ethandrzb/Eurorack_WS2812_LED_Controller/docs/hardware_requirements.md

# Hardware Requirements

## Front Panel 
### UI
- OLED screen
- Encoder
- 6 push buttons
  - Color palette
  - FX change
  - Global settings
  - Mod matrix
  - TODO: MIDI config
  - TODO: Free button connected to gate input 1

### I/O
- 4 CV inputs with passthrough (buffered?)
- 4 gate inputs
- 3 terminals for LED strip (screw or spring?)
- TRS or 5 pin MIDI jacks?

### Rear Panel
- Keyed Eurorack power header
- MIDI input (and thru?)
- 3 terminals for LED strip (same data signal as front panel)
- Header for CV input expander (4 more CV inputs, same spec)
  - I2C ADC
  - DIP switch for I2C address?
  - Put analog front end for expander inputs on expander to save BOM cost

## PCB
- STM32 F446RE MCU and required circuitry
  - 8 MHz external crystal
- Supporting circuitry for
  - CV inputs (and buffers if applicable)
    - +- 5 or 10 Vpp input range
    - Should handle 10 Vpp with no damage
  - Gate inputs
    - Should handle up to 10 Vpp pulse with no damage
    - Dedicated button for Gate 0
  - MIDI input and thru
- SWD programming header (6-pin, MIPI10, or STDC14)
  - STDC14 is same as MIPI10, but includes pins for a serial port
- USB C connector for DFU + DFU button
- USART6 for debugging?
### PCB Info
- JLC Stackup Code: JLC06161H-7628
- Layer Roles
  1. Signal/Power (+5V)
  2. Ground
  3. Signal/Power (+3V3)
  4. Ground
  5. Ground
  6. Signal/Power
