ethandrzb/Eurorack_WS2812_LED_Controller/docs/CubeMX_ADC1_order_8_CV_inputs.png

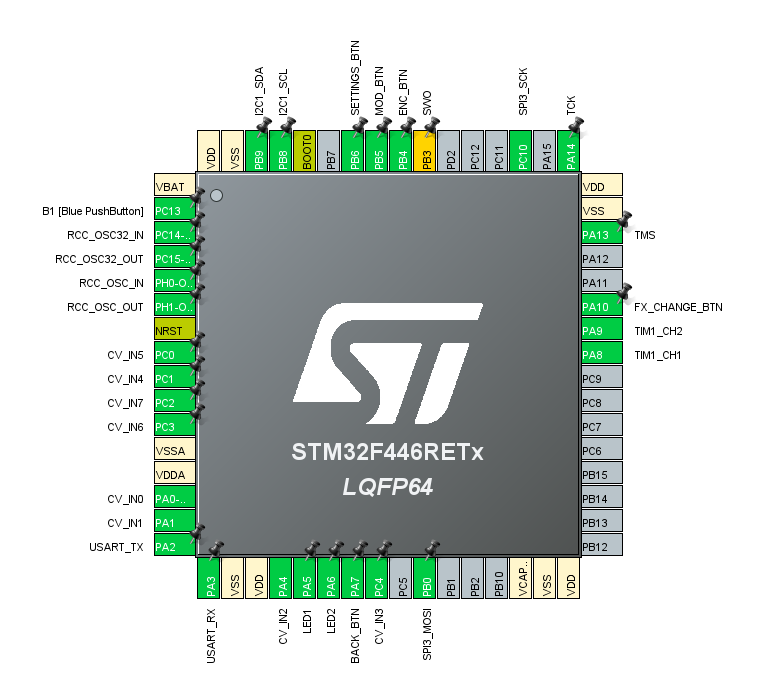
docs/CubeMX_ADC1_order_8_CV_inputs.png
