ethandrzb/Eurorack_WS2812_LED_Controller/eda/Light_Commander/Light_Commander_panel.step

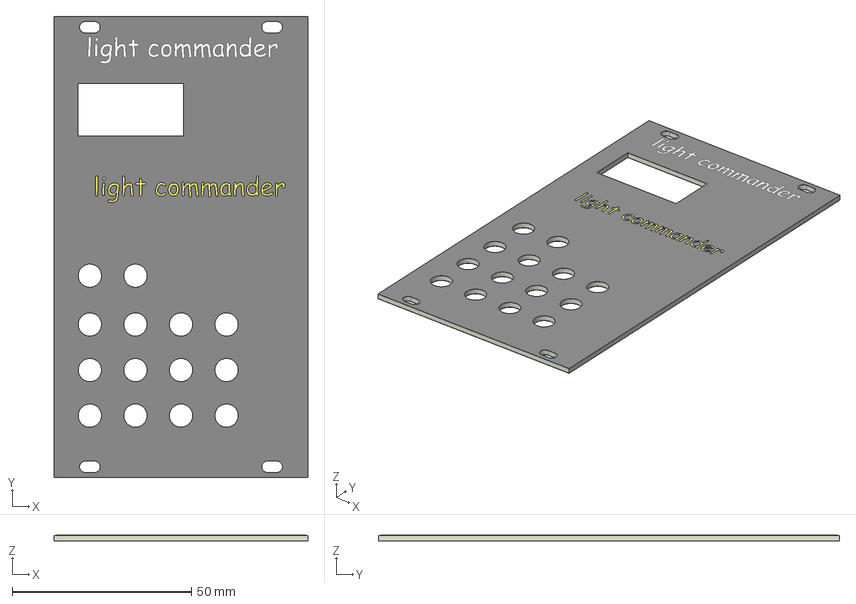
[picture p2: CAD file, 2026-09-30]
eda/Light_Commander/Light_Commander_panel.step
70.8 x 128.5 x 1.64 mm
Light_Commander_panel_copper
Light_Commander_panel_silkscreen
Light_Commander_panel_soldermask x 2
Light_Commander_panel_PCB
