ethandrzb/Eurorack_WS2812_LED_Controller/eda/adc_driver.asc

C1: cap; 49n
C2: cap; 100p
R1: res; 200k
R2: res; 100k
R3: res; 47k
R4: res; 62k
R5: res; 100
R6: res; 10k
R7: res; 100
U1: TL07XH_TL08XH
U2: AD8541
V1: voltage; SINE(0 10 100); AC 1
V2: voltage; 12
V3: voltage; 12
V4: voltage; 2.5
V5: voltage; 3.3
Named nets: 0, vcc, vee, vref
.ac dec 30 1 1e6
.tran 0 130m 100m
