ethandrzb/Eurorack_WS2812_LED_Controller/eda/gate_input.asc

D1: diode; DI_BAT54S
D2: diode; DI_BAT54S
D4: diode; DI_BAT54S
Q1: npn; 2N3904
R1: res; 100k
R2: res; 100k
R3: res; 10k
V1: voltage; SINE(0 10 1k)
V2: voltage; 3.3
V3: voltage; SINE(0 10 1k)
V4: voltage; 3.3
Named nets: 0
.include BAT54S.lib
.tran 3m
