ethandrzb/Eurorack_WS2812_LED_Controller/eda/Light_Commander/Light_Commander.kicad_pcb

## KiCad design eda/Light_Commander/Light_Commander.kicad_pcb (2026-09-30)

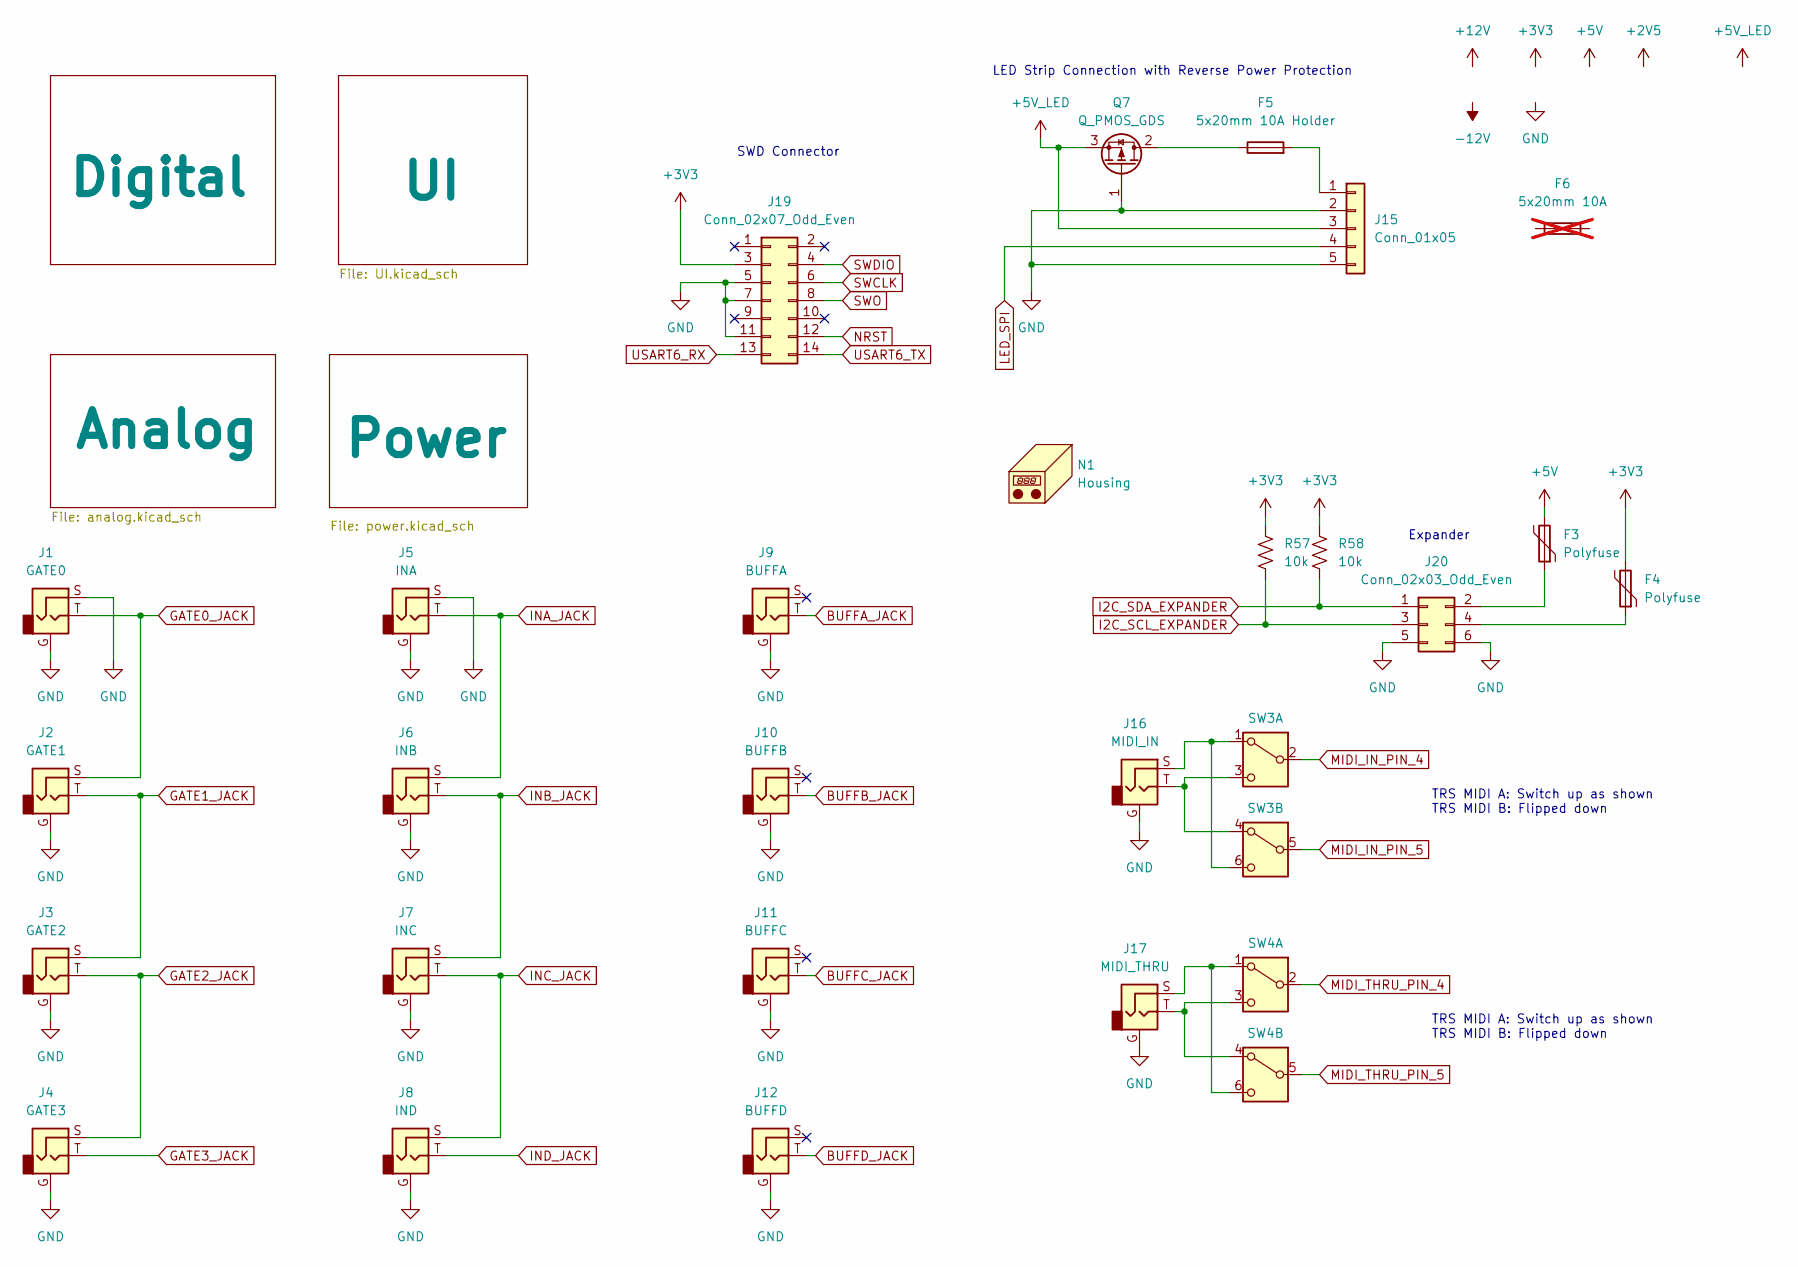
[picture p3: schematic Light_Commander.kicad_sch]

Parts:
F3, F4: Polyfuse; Fuse_0805_2012Metric; Digikey_PN 13-SMDH0805B010TFCT-ND
F5: 5x20mm 10A Holder; 05200101Z; Digikey_PN F1504-ND
F6: 5x20mm 10A; Digikey_PN 0617010.MXP-ND; not fitted
J1: GATE0; PJ301M-12
J2: GATE1; PJ301M-12
J3: GATE2; PJ301M-12
J4: GATE3; PJ301M-12
J5: INA; PJ301M-12
J6: INB; PJ301M-12
J7: INC; PJ301M-12
J8: IND; PJ301M-12
J9: BUFFA; PJ301M-12
J10: BUFFB; PJ301M-12
J11: BUFFC; PJ301M-12
J12: BUFFD; PJ301M-12
J15: Conn_01x05; CUI_TBLH10V-350-05BK; Digikey_PN 102-TBLH10V-350-05BK-ND
J16: MIDI_IN; PJ301M-12_STEREO
J17: MIDI_THRU; PJ301M-12_STEREO
J19: Conn_02x07_Odd_Even; SAMTEC_FTSH-107-01-L-DV-K-A; Digikey_PN FTSH-107-01-L-DV-K-A-ND
J20: Conn_02x03_Odd_Even; IDC-Header_2x03_P2.54mm_Vertical; Digikey_PN S9716-ND
N1: Housing; Light_Commander_Panel
Q7: Q_PMOS_GDS; TO-252-2; Digikey_PN 4786-SSFD6909CT-ND
R57, R58: 10k; R_0805_2012Metric; Digikey_PN 311-10.0KCRCT-ND
SW3, SW4: SW_DPDT_x2; CAS-220TA; Digikey_PN CAS220JCT-ND

Connections:
+3V3: F4.2, J19.3, R57.1, R58.1; also elsewhere on the board
+5V: F3.2; also elsewhere on the board
+5V_LED: J15.3, Q7.3 (S); also elsewhere on the board
BUFFA_JACK: J9.T; also elsewhere on the board
BUFFB_JACK: J10.T; also elsewhere on the board
BUFFC_JACK: J11.T; also elsewhere on the board
BUFFD_JACK: J12.T; also elsewhere on the board
GATE0_JACK: J1.T, J2.S; also elsewhere on the board
GATE1_JACK: J2.T, J3.S; also elsewhere on the board
GATE2_JACK: J3.T, J4.S; also elsewhere on the board
GATE3_JACK: J4.T; also elsewhere on the board
GND: J1.G, J1.S, J2.G, J3.G, J4.G, J5.G, J5.S, J6.G, J7.G, J8.G, J9.G, J10.G, J11.G, J12.G, J15.2, J15.5, J16.G, J17.G, J19.5, J19.7, J19.11, J20.5, J20.6, Q7.1 (G); also elsewhere on the board
I2C_SCL_EXPANDER: J20.3, R57.2; also elsewhere on the board
I2C_SDA_EXPANDER: J20.1, R58.2; also elsewhere on the board
INA_JACK: J5.T, J6.S; also elsewhere on the board
INB_JACK: J6.T, J7.S; also elsewhere on the board
INC_JACK: J7.T, J8.S; also elsewhere on the board
IND_JACK: J8.T; also elsewhere on the board
LED_SPI: J15.4; also elsewhere on the board
MIDI_IN_PIN_4: SW3.2 (B); also elsewhere on the board
MIDI_IN_PIN_5: SW3.5 (B); also elsewhere on the board
MIDI_THRU_PIN_4: SW4.2 (B); also elsewhere on the board
MIDI_THRU_PIN_5: SW4.5 (B); also elsewhere on the board
NRST: J19.12; also elsewhere on the board
unnamed: F5.2, J15.1
unnamed: F3.1, J20.2
unnamed: F4.1, J20.4
unnamed: F5.1, Q7.2 (D)
unnamed: J16.S, SW3.1 (A), SW3.6 (C)
unnamed: J16.T, SW3.3 (C), SW3.4 (A)
unnamed: J17.S, SW4.1 (A), SW4.6 (C)
unnamed: J17.T, SW4.3 (C), SW4.4 (A)
SWCLK: J19.6; also elsewhere on the board
SWDIO: J19.4; also elsewhere on the board
SWO: J19.8; also elsewhere on the board
USART6_RX: J19.13; also elsewhere on the board
USART6_TX: J19.14; also elsewhere on the board

Notes on the sheet:
TRS MIDI A: Switch up as shown TRS MIDI B: Flipped down
Expander
SWD Connector
LED Strip Connection with Reverse Power Protection

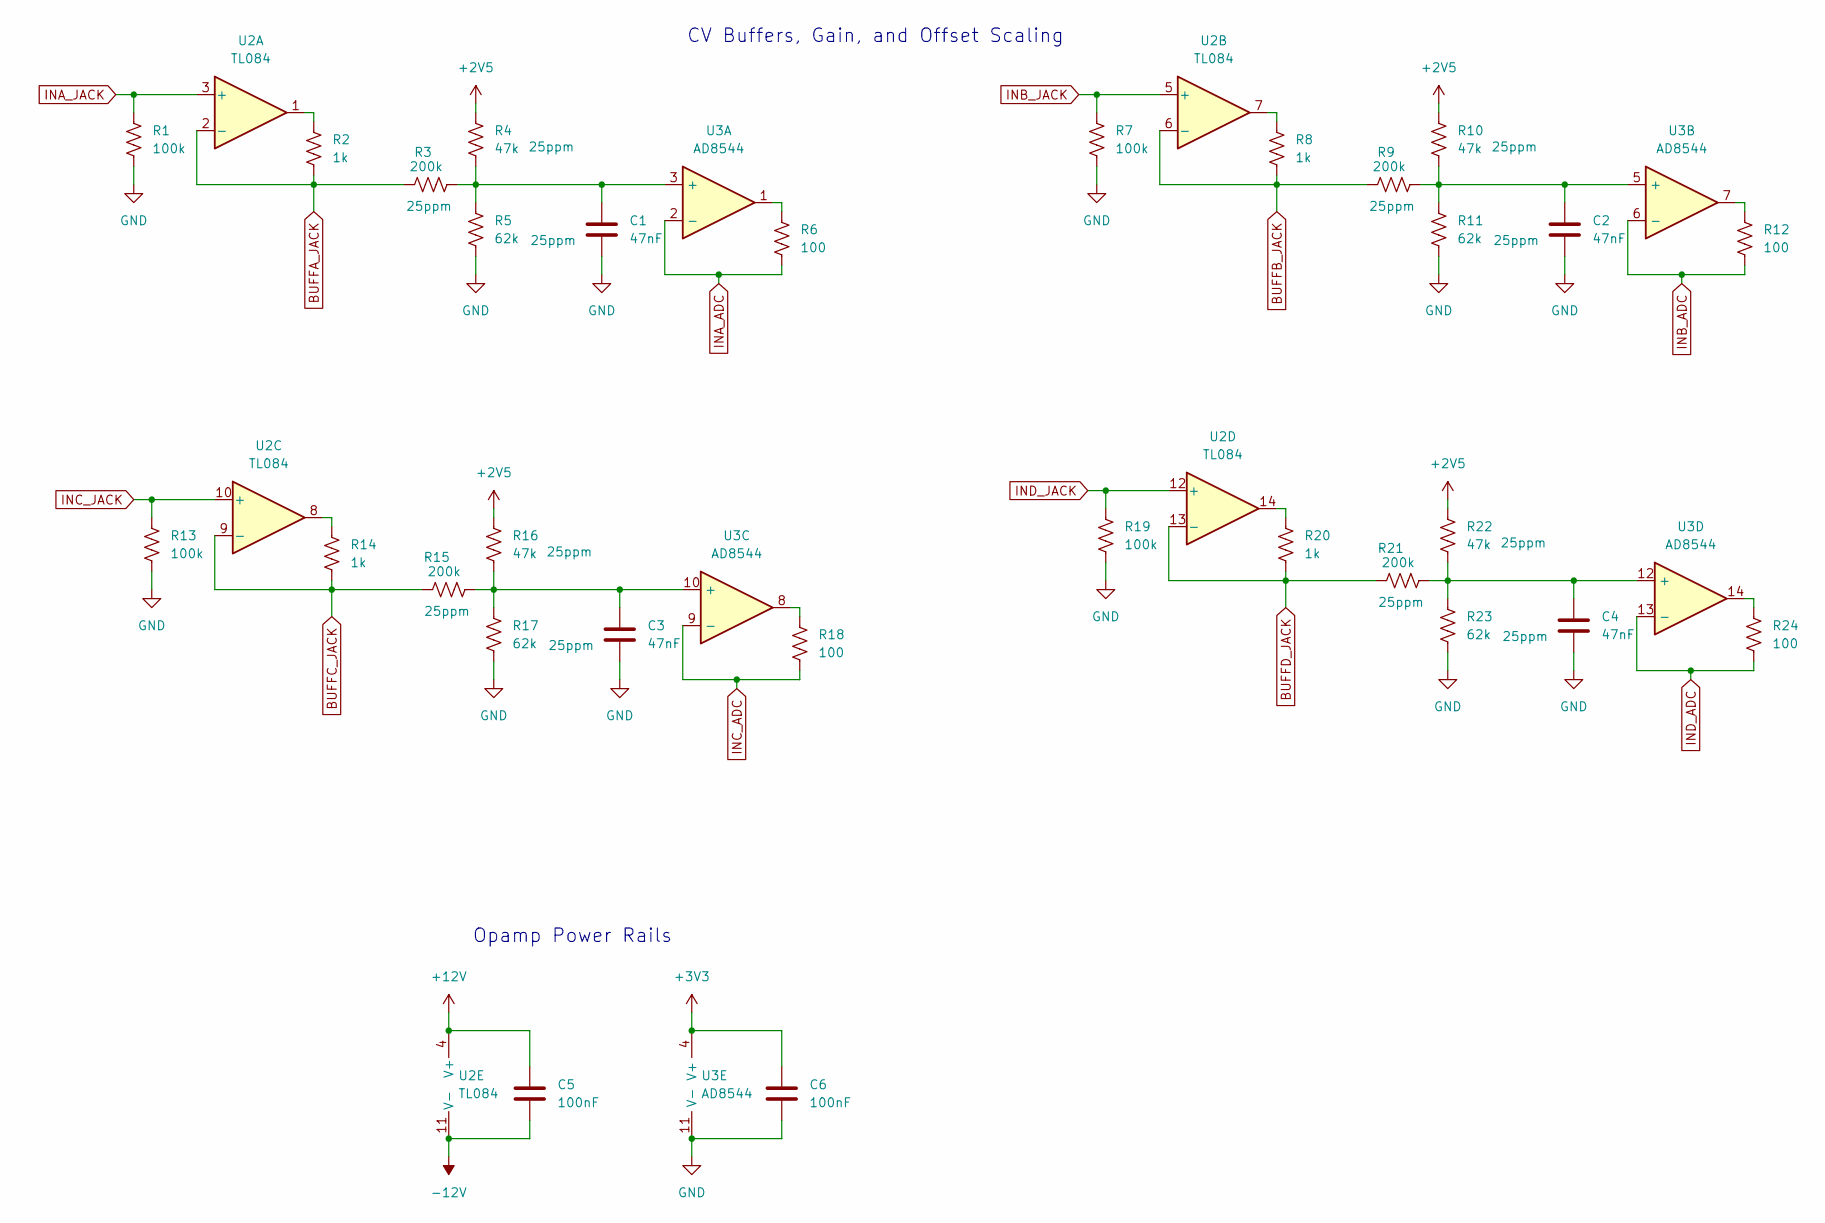
[picture p4: schematic analog.kicad_sch]

Parts:
C1, C2, C3, C4: 47nF; C_0805_2012Metric; Digikey_PN 399-C0805C473J3GECTUCT-ND
C5, C6: 100nF; C_0805_2012Metric; Digikey_PN 1276-1003-1-ND
R1, R7, R13, R19: 100k; R_0805_2012Metric; Digikey_PN 311-100KCRCT-ND
R2, R8, R14, R20: 1k; R_0805_2012Metric; Digikey_PN 541-1.00KCCT-ND
R3, R9, R15, R21: 200k; R_0805_2012Metric; Digikey_PN RG20P200KBCT-ND
R4, R10, R16, R22: 47k; R_0805_2012Metric; Digikey_PN RG20P47.0KBCT-ND
R5, R11, R17, R23: 62k; R_0805_2012Metric; Digikey_PN P62KDACT-ND
R6, R12, R18, R24: 100; R_0805_2012Metric; Digikey_PN 311-100CRCT-ND
U2: TL084; SOIC-14_3.9x8.7mm_P1.27mm; Digikey_PN 296-TL084HIDRCT-ND
U3: AD8544; SOIC-14_3.9x8.7mm_P1.27mm; Digikey_PN AD8544ARZ-REELCT-ND

Connections:
+2V5: R4.1, R10.1, R16.1, R22.1; also elsewhere on the board
+3V3: C6.1, U3.4 (V+); also elsewhere on the board
+12V: C5.1, U2.4 (V+); also elsewhere on the board
-12V: C5.2, U2.11 (V-); also elsewhere on the board
BUFFA_JACK: R2.2, R3.1, U2.2 (-); also elsewhere on the board
BUFFB_JACK: R8.2, R9.1, U2.6 (-); also elsewhere on the board
BUFFC_JACK: R14.2, R15.1, U2.9 (-); also elsewhere on the board
BUFFD_JACK: R20.2, R21.1, U2.13 (-); also elsewhere on the board
GND: C1.2, C2.2, C3.2, C4.2, C6.2, R1.2, R5.2, R7.2, R11.2, R13.2, R17.2, R19.2, R23.2, U3.11 (V-); also elsewhere on the board
INA_ADC: R6.1, U3.2 (-); also elsewhere on the board
INA_JACK: R1.1, U2.3 (+); also elsewhere on the board
INB_ADC: R12.1, U3.6 (-); also elsewhere on the board
INB_JACK: R7.1, U2.5 (+); also elsewhere on the board
INC_ADC: R18.1, U3.9 (-); also elsewhere on the board
INC_JACK: R13.1, U2.10 (+); also elsewhere on the board
IND_ADC: R24.1, U3.13 (-); also elsewhere on the board
IND_JACK: R19.1, U2.12 (+); also elsewhere on the board
unnamed: R2.1, U2.1
unnamed: R6.2, U3.1
unnamed: R8.1, U2.7
unnamed: R12.2, U3.7
unnamed: R14.1, U2.8
unnamed: R18.2, U3.8
unnamed: R20.1, U2.14
unnamed: R24.2, U3.14
unnamed: C1.1, R3.2, R4.2, R5.1, U3.3 (+)
unnamed: C2.1, R9.2, R10.2, R11.1, U3.5 (+)
unnamed: C3.1, R15.2, R16.2, R17.1, U3.10 (+)
unnamed: C4.1, R21.2, R22.2, R23.1, U3.12 (+)

Notes on the sheet:
CV Buffers, Gain, and Offset Scaling
Opamp Power Rails

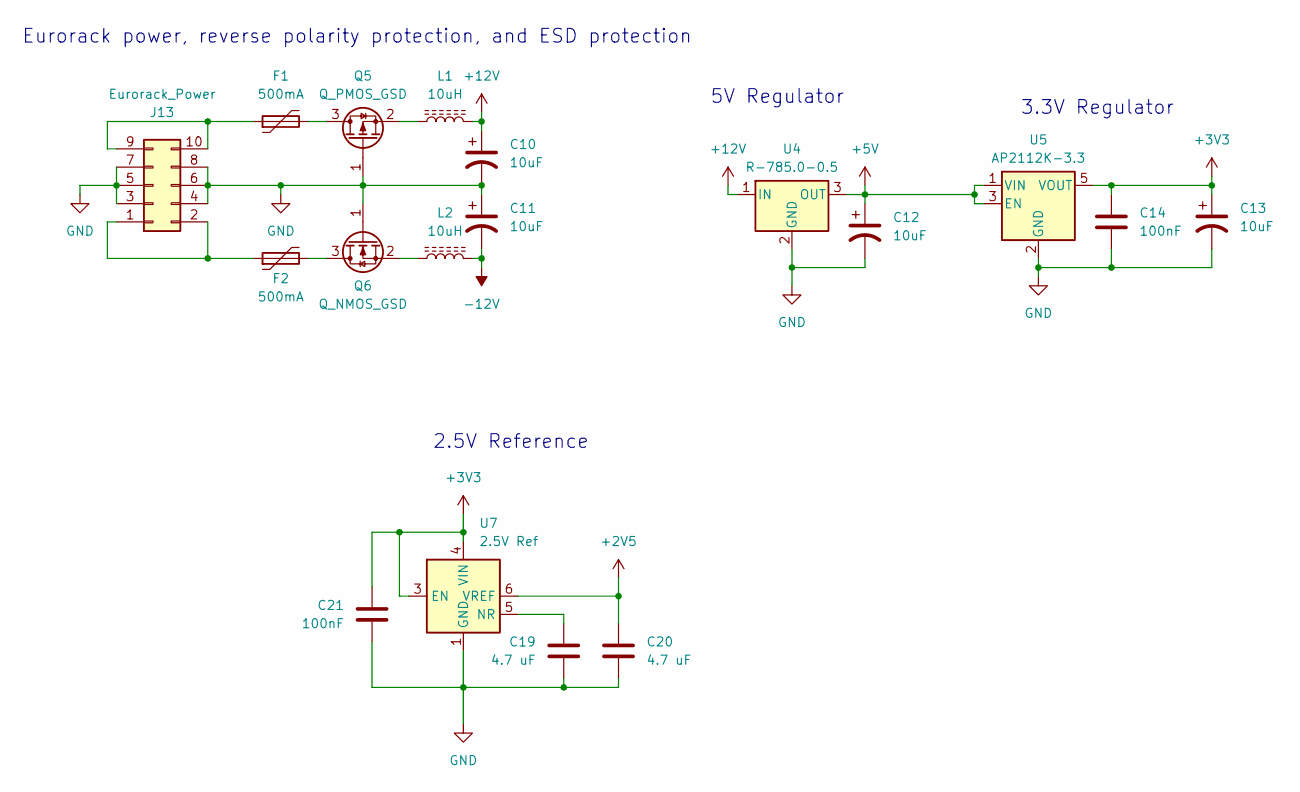
[picture p5: schematic power.kicad_sch]

Parts:
C10, C11, C12, C13: 10uF; C_Elec_6.3x7.7; Digikey_PN 732-11937-1-ND
C14, C21: 100nF; C_0805_2012Metric; Digikey_PN 1276-1003-1-ND
C19, C20: 4.7 uF; C_0805_2012Metric; Digikey_PN 1276-1244-1-ND
F1, F2: 500mA; Fuse_1206_3216Metric; Digikey_PN F2110CT-ND
J13: Eurorack_Power; IDC-Header_2x05_P2.54mm_Vertical; Digikey_PN S9169-ND
L1, L2: 10uH; L_1210_3225Metric; Digikey_PN 445-TFM322512ALVA100MTAACT-ND
Q5: Q_PMOS_GSD; SOT-23-3; Digikey_PN 4518-SI2303CT-ND
Q6: Q_NMOS_GSD; SOT-23-3; Digikey_PN 4518-SI2318ACT-ND
U4: R-785.0-0.5; Converter_DCDC_RECOM_R-78E-0.5_THT; Digikey_PN 945-R-78K5.0-0.5-ND
U5: AP2112K-3.3; SOT-23-5; Digikey_PN AP2112K-3.3TRG1DICT-ND
U7: 2.5V Ref; SOT-23-6; Digikey_PN 296-REF35250QDBVRCT-ND

Connections:
+2V5: C20.2, U7.6 (VREF); also elsewhere on the board
+3V3: C13.1, C14.2, C21.2, U5.5 (VOUT), U7.3 (EN), U7.4 (VIN); also elsewhere on the board
+5V: C12.1, U4.3 (OUT), U5.1 (VIN), U5.3 (EN); also elsewhere on the board
+12V: C10.1, L1.2, U4.1 (IN); also elsewhere on the board
-12V: C11.2, L2.2; also elsewhere on the board
GND: C10.2, C11.1, C12.2, C13.2, C14.1, C19.1, C20.1, C21.1, J13.3, J13.4, J13.5, J13.6, J13.7, J13.8, Q5.1 (G), Q6.1 (G), U4.2 (GND), U5.2 (GND), U7.1 (GND), U7.2 (GND); also elsewhere on the board
unnamed: F2.1, J13.1, J13.2
unnamed: F1.1, J13.9, J13.10
unnamed: F1.2, Q5.3 (D)
unnamed: L1.1, Q5.2 (S)
unnamed: F2.2, Q6.3 (D)
unnamed: L2.1, Q6.2 (S)
unnamed: C19.2, U7.5 (NR)

Notes on the sheet:
5V Regulator
2.5V Reference
Eurorack power, reverse polarity protection, and ESD protection
3.3V Regulator

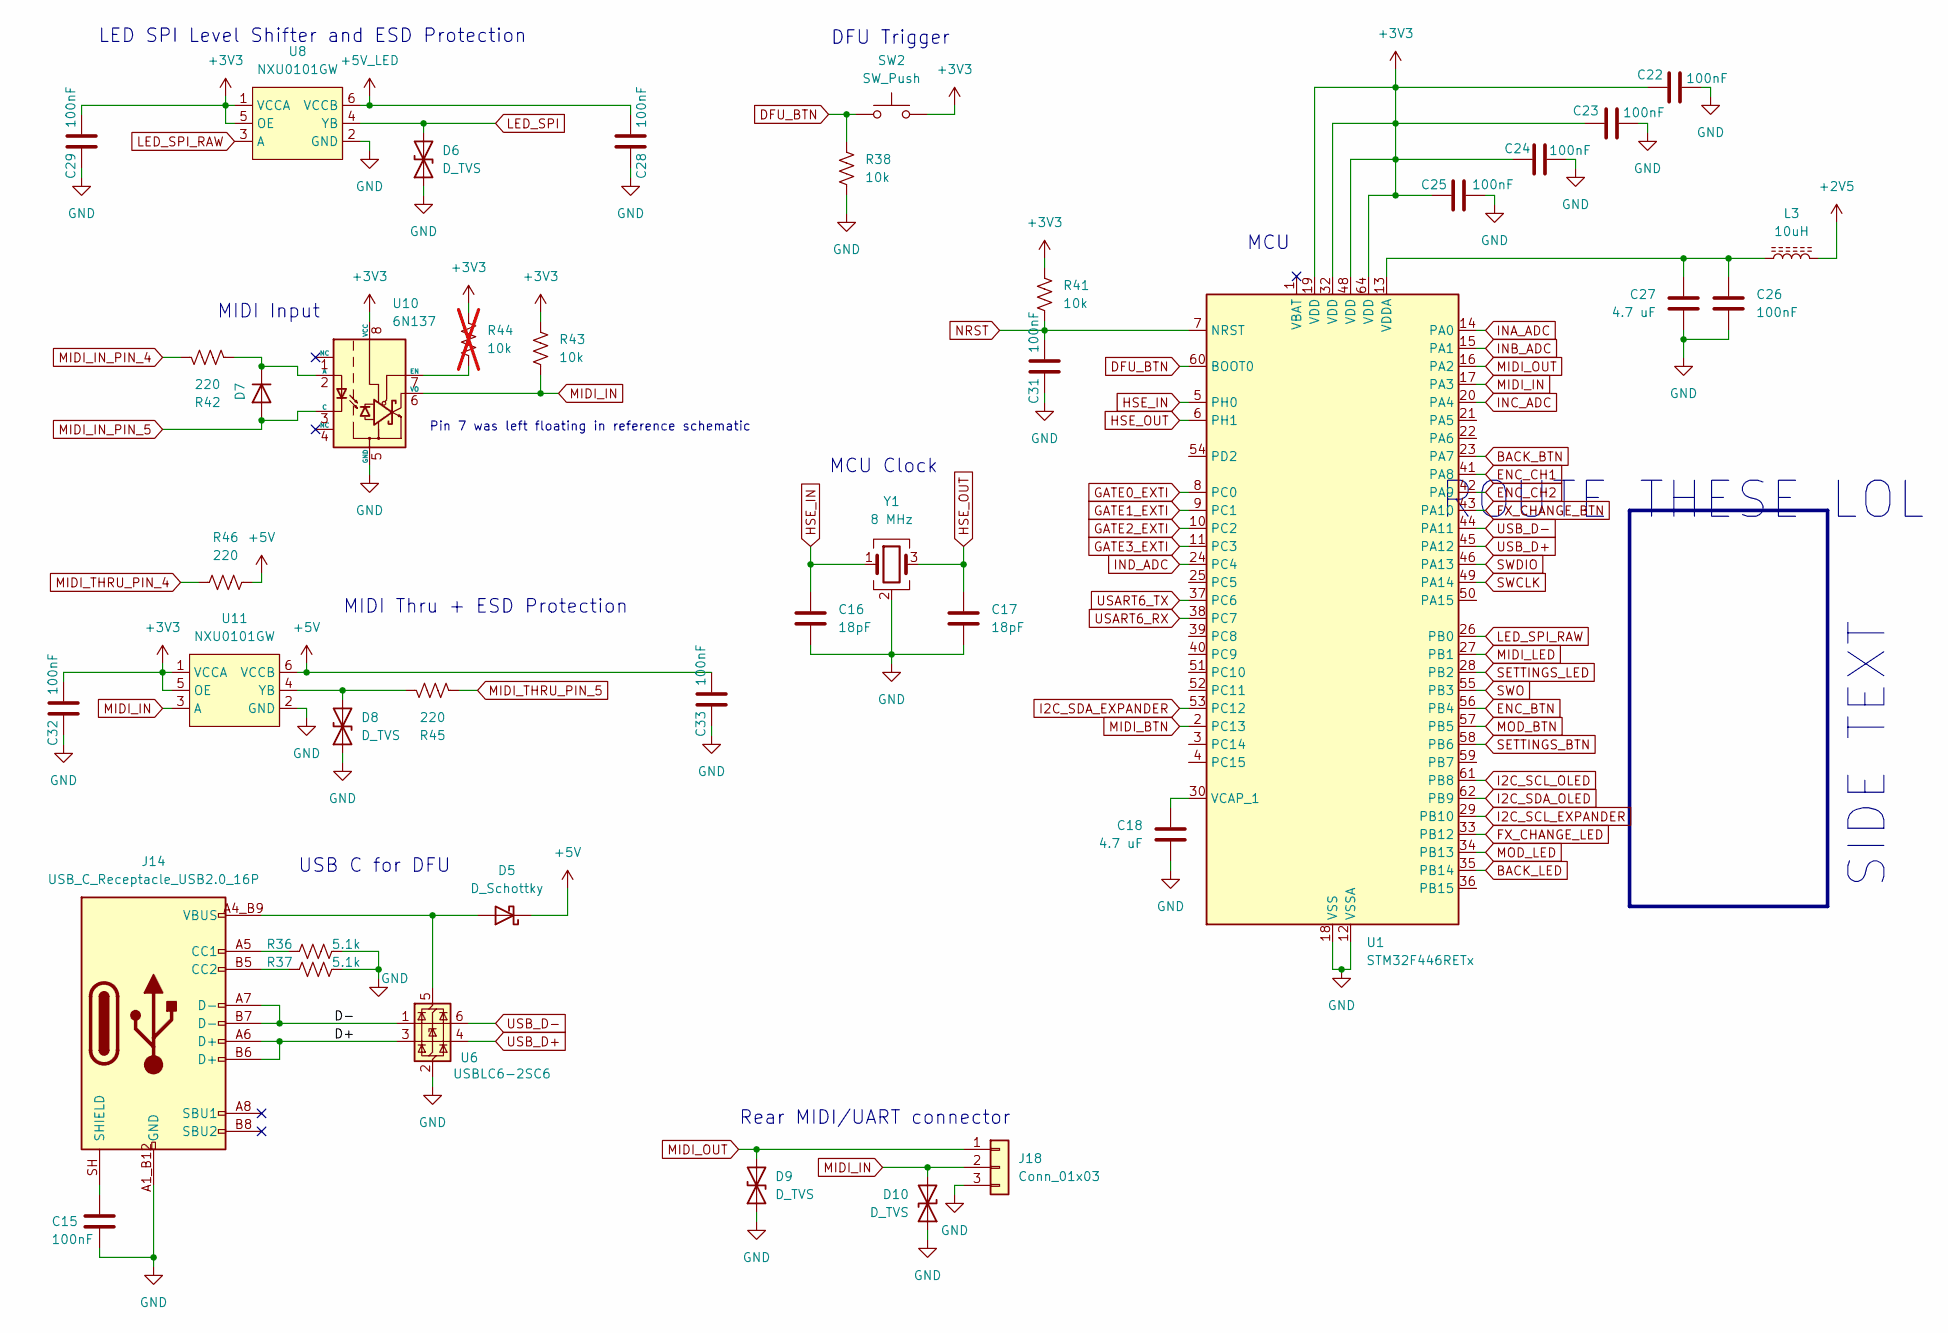
[picture p6: schematic digital.kicad_sch]

Parts:
C15, C22, C23, C24, C25, C26, C28, C29, C31, C32, C33: 100nF; C_0805_2012Metric; Digikey_PN 1276-1003-1-ND
C16, C17: 18pF; C_0402_1005Metric; Digikey_PN 490-5858-1-ND
C18, C27: 4.7 uF; C_0805_2012Metric; Digikey_PN 1276-1244-1-ND
D5: D_Schottky; D_SOD-123; Digikey_PN 5399-1N5817WCT-ND
D6, D8, D9, D10: D_TVS; D_SOD-123F; Digikey_PN 4786-GSMF5.0CACT-ND
D7: D; D_SOD-123; Digikey_PN 1N4148WTPMSCT-ND
J14: USB_C_Receptacle_USB2.0_16P; UJ20-C-H-G-SMT-1-P16-TR; Digikey_PN 2223-UJ20-C-H-G-SMT-1-P16-TRCT-ND
J18: Conn_01x03; PinHeader_1x03_P2.54mm_Vertical
L3: 10uH; L_1210_3225Metric; Digikey_PN 445-TFM322512ALVA100MTAACT-ND
R36, R37: 5.1k; R_0805_2012Metric; Digikey_PN 311-5.10KCRCT-ND
R38, R41, R43: 10k; R_0805_2012Metric; Digikey_PN 311-10.0KCRCT-ND
R42, R45, R46: 220; R_0805_2012Metric; Digikey_PN 311-220ARCT-ND
R44: 10k; R_0805_2012Metric; Digikey_PN 311-10.0KCRCT-ND; not fitted
SW2: SW_Push; TS09-63-25-R-160-SMT-TR; Digikey_PN 2223-TS09-63-25-R-260-SMT-TRCT-ND
U1: STM32F446RETx; LQFP-64_10x10mm_P0.5mm; Digikey_PN 497-15376-ND
U6: USBLC6-2SC6; SOT-23-6; Digikey_PN 497-5235-1-ND
U8: NXU0101GW; SOT-363_SC-70-6
U10: 6N137; SOP-8_6.605x9.655mm_P2.54mm; Digikey_PN 58-6N137SMT&RCT-ND
U11: NXU0101GW; SOT-363_SC-70-6; Digikey_PN 1727-NXU0101GWHCT-ND
Y1: 8 MHz; ECS-80-18-33-JGN-TR; Digikey_PN 50-ECS-80-18-33-JGN-CT-ND

Connections:
+2V5: L3.2; also elsewhere on the board
+3V3: C22.2, C23.1, C24.1, C25.2, C29.1, C32.1, R41.1, R43.1, R44.1, SW2.2, U1.19 (VDD), U1.32 (VDD), U1.48 (VDD), U1.64 (VDD), U8.1 (VCCA), U8.5 (OE), U10.8 (VCC), U11.1 (VCCA), U11.5 (OE); also elsewhere on the board
+5V: C33.1, D5.1 (K), R46.1, U11.6 (VCCB); also elsewhere on the board
+5V_LED: C28.1, U8.6 (VCCB); also elsewhere on the board
/Digital/D+: J14.A6 (D+), J14.B6 (D+), U6.3 (I/O2)
/Digital/D-: J14.A7 (D-), J14.B7 (D-), U6.1 (I/O1)
BACK_BTN: U1.23 (PA7); also elsewhere on the board
BACK_LED: U1.35 (PB14); also elsewhere on the board
DFU_BTN: R38.1, SW2.1, U1.60 (BOOT0)
ENC_BTN: U1.56 (PB4); also elsewhere on the board
ENC_CH1: U1.41 (PA8); also elsewhere on the board
ENC_CH2: U1.42 (PA9); also elsewhere on the board
FX_CHANGE_BTN: U1.43 (PA10); also elsewhere on the board
FX_CHANGE_LED: U1.33 (PB12); also elsewhere on the board
GATE0_EXTI: U1.8 (PC0); also elsewhere on the board
GATE1_EXTI: U1.9 (PC1); also elsewhere on the board
GATE2_EXTI: U1.10 (PC2); also elsewhere on the board
GATE3_EXTI: U1.11 (PC3); also elsewhere on the board
GND: C15.2, C16.2, C17.2, C18.1, C22.1, C23.2, C24.2, C25.1, C26.1, C27.1, C28.2, C29.2, C31.2, C32.2, C33.2, D6.1 (A1), D8.1 (A1), D9.1 (A1), D10.1 (A1), J14.A1_B12 (GND), J14.B1_A12 (GND), J18.3, R36.1, R37.1, R38.2, U1.12 (VSSA), U1.18 (VSS), U1.31 (VSS), U1.47 (VSS), U1.63 (VSS), U6.2 (GND), U8.2 (GND), U10.5 (GND), U11.2 (GND), Y1.2 (G), Y1.4 (G); also elsewhere on the board
HSE_IN: C16.1, U1.5 (PH0), Y1.1
HSE_OUT: C17.1, U1.6 (PH1), Y1.3
I2C_SCL_EXPANDER: U1.29 (PB10); also elsewhere on the board
I2C_SCL_OLED: U1.61 (PB8); also elsewhere on the board
I2C_SDA_EXPANDER: U1.53 (PC12); also elsewhere on the board
I2C_SDA_OLED: U1.62 (PB9); also elsewhere on the board
INA_ADC: U1.14 (PA0); also elsewhere on the board
INB_ADC: U1.15 (PA1); also elsewhere on the board
INC_ADC: U1.20 (PA4); also elsewhere on the board
IND_ADC: U1.24 (PC4); also elsewhere on the board
LED_SPI: D6.2 (A2), U8.4 (YB); also elsewhere on the board
LED_SPI_RAW: U1.26 (PB0), U8.3 (A)
MIDI_BTN: U1.2 (PC13); also elsewhere on the board
MIDI_IN: D10.2 (A2), J18.2, R43.2, U1.17 (PA3), U10.6 (VO), U11.3 (A)
MIDI_IN_PIN_4: R42.2; also elsewhere on the board
MIDI_IN_PIN_5: D7.2 (A), U10.3 (C); also elsewhere on the board
MIDI_LED: U1.27 (PB1); also elsewhere on the board
MIDI_OUT: D9.2 (A2), J18.1, U1.16 (PA2)
MIDI_THRU_PIN_4: R46.2; also elsewhere on the board
MIDI_THRU_PIN_5: R45.1; also elsewhere on the board
MOD_BTN: U1.57 (PB5); also elsewhere on the board
MOD_LED: U1.34 (PB13); also elsewhere on the board
NRST: C31.1, R41.2, U1.7 (NRST); also elsewhere on the board
unnamed: D5.2 (A), J14.A4_B9 (VBUS), J14.B4_A9 (VBUS), U6.5 (VBUS)
unnamed: D7.1 (K), R42.1, U10.2 (A)
unnamed: D8.2 (A2), R45.2, U11.4 (YB)
unnamed: J14.A5 (CC1), R36.2
unnamed: J14.B5 (CC2), R37.2
unnamed: C15.1, J14.SH (SHIELD)
unnamed: C18.2, U1.30 (VCAP_1)
unnamed: C26.2, C27.2, L3.1, U1.13 (VDDA)
unnamed: R44.2, U10.7 (EN)
SETTINGS_BTN: U1.58 (PB6); also elsewhere on the board
SETTINGS_LED: U1.28 (PB2); also elsewhere on the board
SWCLK: U1.49 (PA14); also elsewhere on the board
SWDIO: U1.46 (PA13); also elsewhere on the board
SWO: U1.55 (PB3); also elsewhere on the board
USART6_RX: U1.38 (PC7); also elsewhere on the board
USART6_TX: U1.37 (PC6); also elsewhere on the board
USB_D+: U1.45 (PA12), U6.4 (I/O2)
USB_D-: U1.44 (PA11), U6.6 (I/O1)

Notes on the sheet:
Rear MIDI/UART connector
MCU
MIDI Input
USB C for DFU
SIDE TEXT
MCU Clock
MIDI Thru + ESD Protection
DFU Trigger
Pin 7 was left floating in reference schematic
ROUTE THESE LOL
LED SPI Level Shifter and ESD Protection

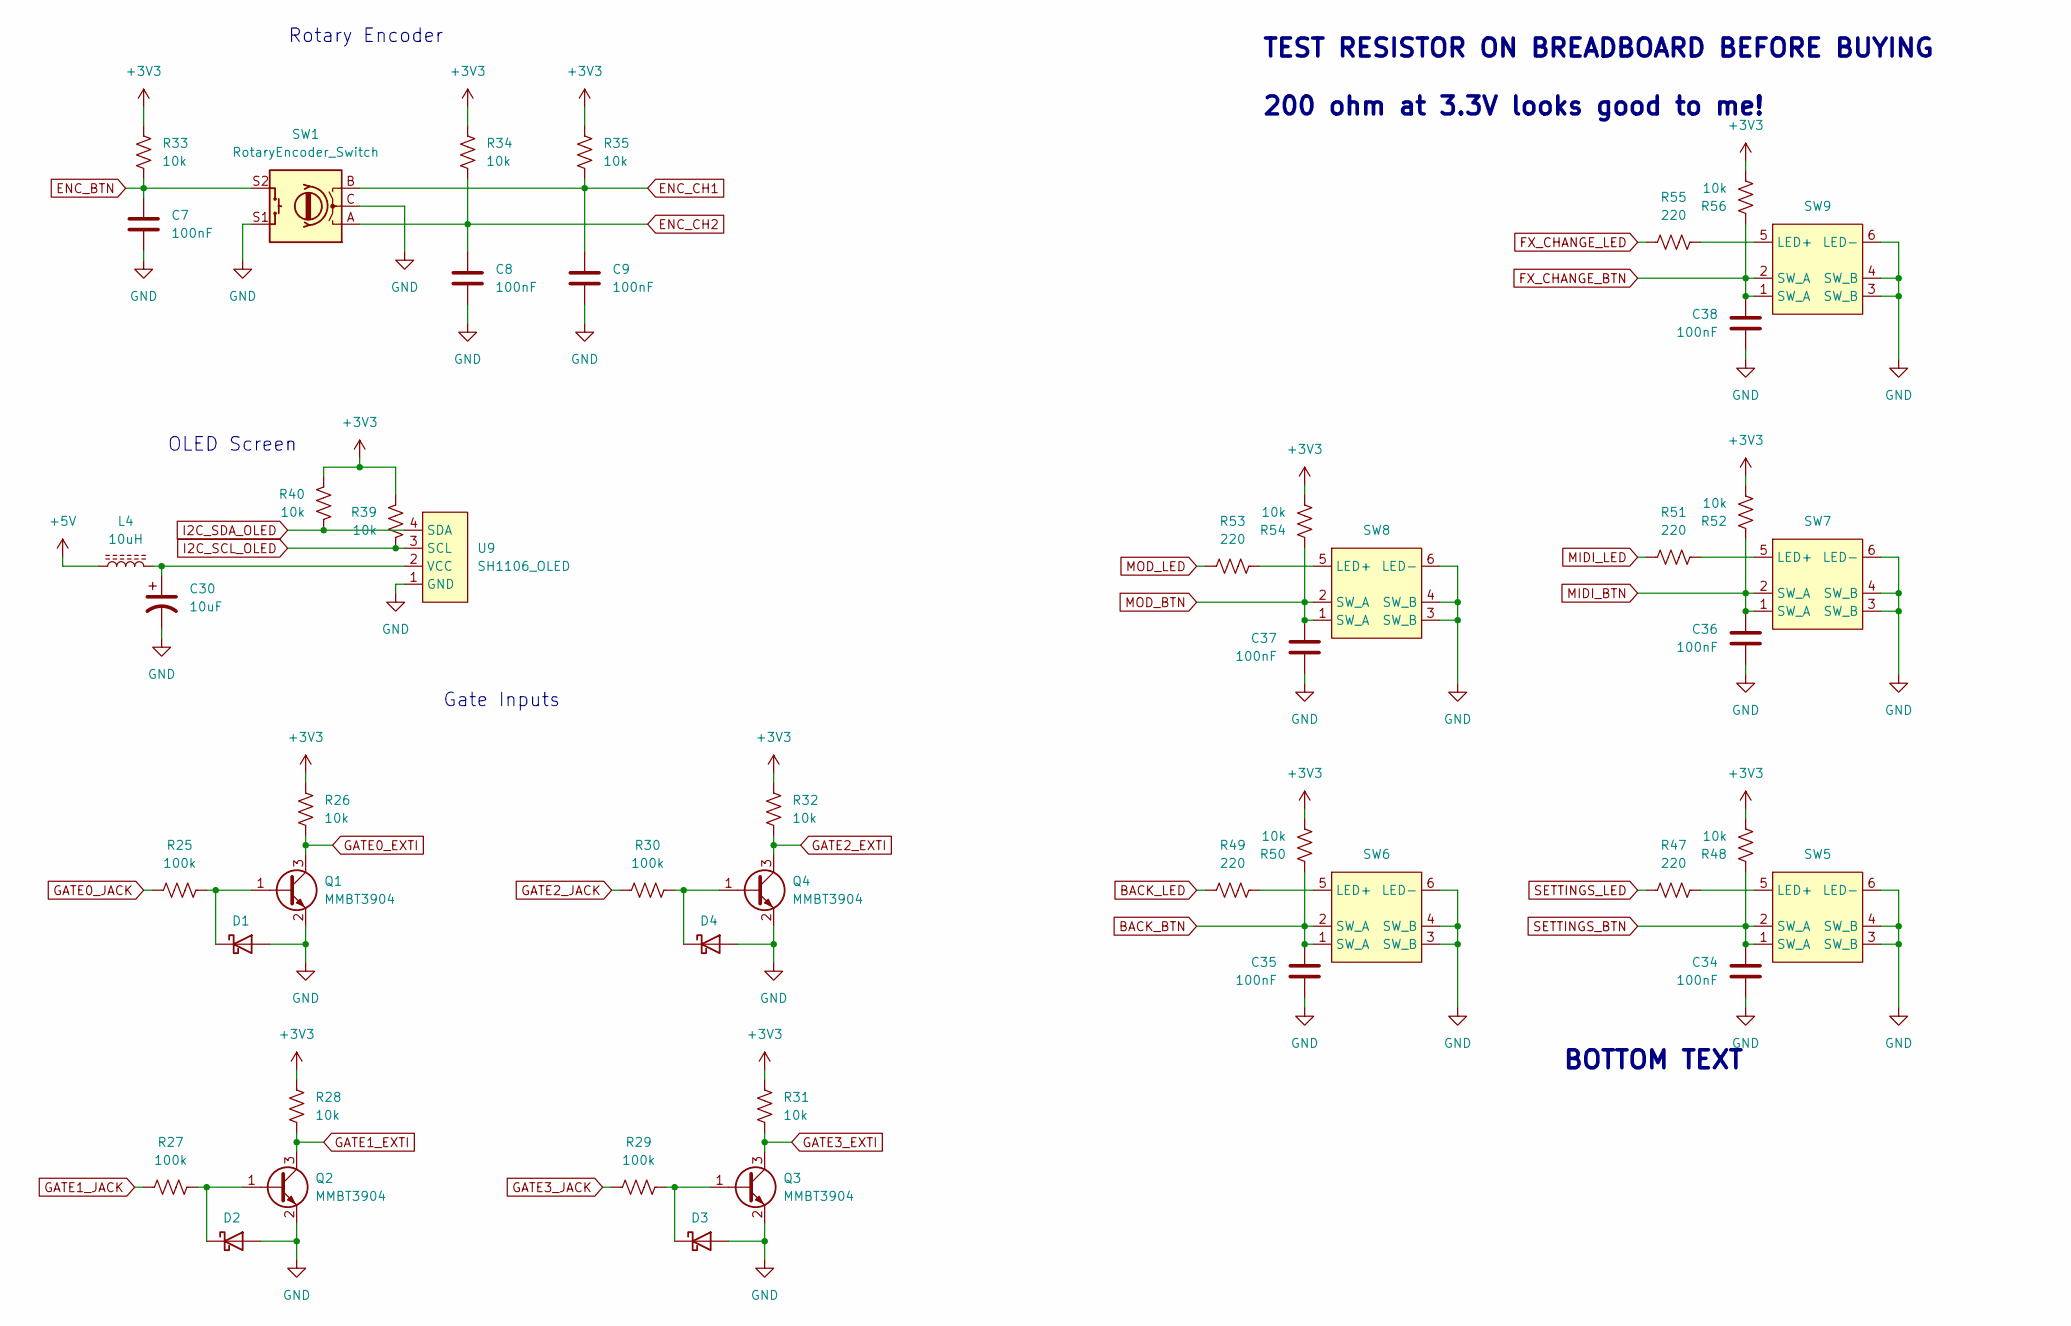
[picture p7: schematic UI.kicad_sch]

Parts:
C7, C8, C9, C34, C35, C36, C37, C38: 100nF; C_0805_2012Metric; Digikey_PN 1276-1003-1-ND
C30: 10uF; C_Elec_6.3x7.7; Digikey_PN 732-11937-1-ND
D1, D2, D3, D4: GSBAT54W; D_SOD-123; Digikey_PN 4786-GSBAT54WCT-ND
L4: 10uH; L_1210_3225Metric; Digikey_PN 445-TFM322512ALVA100MTAACT-ND
Q1, Q2, Q3, Q4: MMBT3904; SOT-23; Digikey_PN 4786-MMBT3904CT-ND
R25, R27, R29, R30: 100k; R_0805_2012Metric; Digikey_PN 311-100KCRCT-ND
R26, R28, R31, R32, R33, R34, R35, R39, R40, R48, R50, R52, R54, R56: 10k; R_0805_2012Metric; Digikey_PN 311-10.0KCRCT-ND
R47, R49, R51, R53, R55: 220; R_0805_2012Metric; Digikey_PN 311-220ARCT-ND
SW1: RotaryEncoder_Switch; PEC11R-4220K-S0024; Digikey_PN PEC11R-4220K-S0024-ND
SW5, SW6, SW7, SW8, SW9: SW_Tact_Low_Profile_LED_ExtraHoles
U9: SH1106_OLED; SH1106_1.3in_OLED

Connections:
+3V3: R26.1, R28.1, R31.1, R32.1, R33.1, R34.1, R35.1, R39.1, R40.1, R48.2, R50.2, R52.2, R54.2, R56.2; also elsewhere on the board
+5V: L4.1; also elsewhere on the board
BACK_BTN: C35.1, R50.1, SW6.1 (SW_A), SW6.2 (SW_A); also elsewhere on the board
BACK_LED: R49.2; also elsewhere on the board
ENC_BTN: C7.1, R33.2, SW1.S2; also elsewhere on the board
ENC_CH1: C9.1, R35.2, SW1.B; also elsewhere on the board
ENC_CH2: C8.1, R34.2, SW1.A; also elsewhere on the board
FX_CHANGE_BTN: C38.1, R56.1, SW9.1 (SW_A), SW9.2 (SW_A); also elsewhere on the board
FX_CHANGE_LED: R55.2; also elsewhere on the board
GATE0_EXTI: Q1.3 (C), R26.2; also elsewhere on the board
GATE0_JACK: R25.1; also elsewhere on the board
GATE1_EXTI: Q2.3 (C), R28.2; also elsewhere on the board
GATE1_JACK: R27.1; also elsewhere on the board
GATE2_EXTI: Q4.3 (C), R32.2; also elsewhere on the board
GATE2_JACK: R30.1; also elsewhere on the board
GATE3_EXTI: Q3.3 (C), R31.2; also elsewhere on the board
GATE3_JACK: R29.1; also elsewhere on the board
GND: C7.2, C8.2, C9.2, C30.2, C34.2, C35.2, C36.2, C37.2, C38.2, D1.2 (A), D2.2 (A), D3.2 (A), D4.2 (A), Q1.2 (E), Q2.2 (E), Q3.2 (E), Q4.2 (E), SW1.C, SW1.S1, SW5.3 (SW_B), SW5.4 (SW_B), SW5.6 (LED-), SW6.3 (SW_B), SW6.4 (SW_B), SW6.6 (LED-), SW7.3 (SW_B), SW7.4 (SW_B), SW7.6 (LED-), SW8.3 (SW_B), SW8.4 (SW_B), SW8.6 (LED-), SW9.3 (SW_B), SW9.4 (SW_B), SW9.6 (LED-), U9.1 (GND); also elsewhere on the board
I2C_SCL_OLED: R39.2, U9.3 (SCL); also elsewhere on the board
I2C_SDA_OLED: R40.2, U9.4 (SDA); also elsewhere on the board
MIDI_BTN: C36.1, R52.1, SW7.1 (SW_A), SW7.2 (SW_A); also elsewhere on the board
MIDI_LED: R51.2; also elsewhere on the board
MOD_BTN: C37.1, R54.1, SW8.1 (SW_A), SW8.2 (SW_A); also elsewhere on the board
MOD_LED: R53.2; also elsewhere on the board
unnamed: D1.1 (K), Q1.1 (B), R25.2
unnamed: D2.1 (K), Q2.1 (B), R27.2
unnamed: D3.1 (K), Q3.1 (B), R29.2
unnamed: D4.1 (K), Q4.1 (B), R30.2
unnamed: R47.1, SW5.5 (LED+)
unnamed: R49.1, SW6.5 (LED+)
unnamed: R51.1, SW7.5 (LED+)
unnamed: R53.1, SW8.5 (LED+)
unnamed: R55.1, SW9.5 (LED+)
unnamed: C30.1, L4.2, U9.2 (VCC)
SETTINGS_BTN: C34.1, R48.1, SW5.1 (SW_A), SW5.2 (SW_A); also elsewhere on the board
SETTINGS_LED: R47.2; also elsewhere on the board

Notes on the sheet:
BOTTOM TEXT
OLED Screen
Rotary Encoder
TEST RESISTOR ON BREADBOARD BEFORE BUYING 200 ohm at 3.3V looks good to me!
Gate Inputs

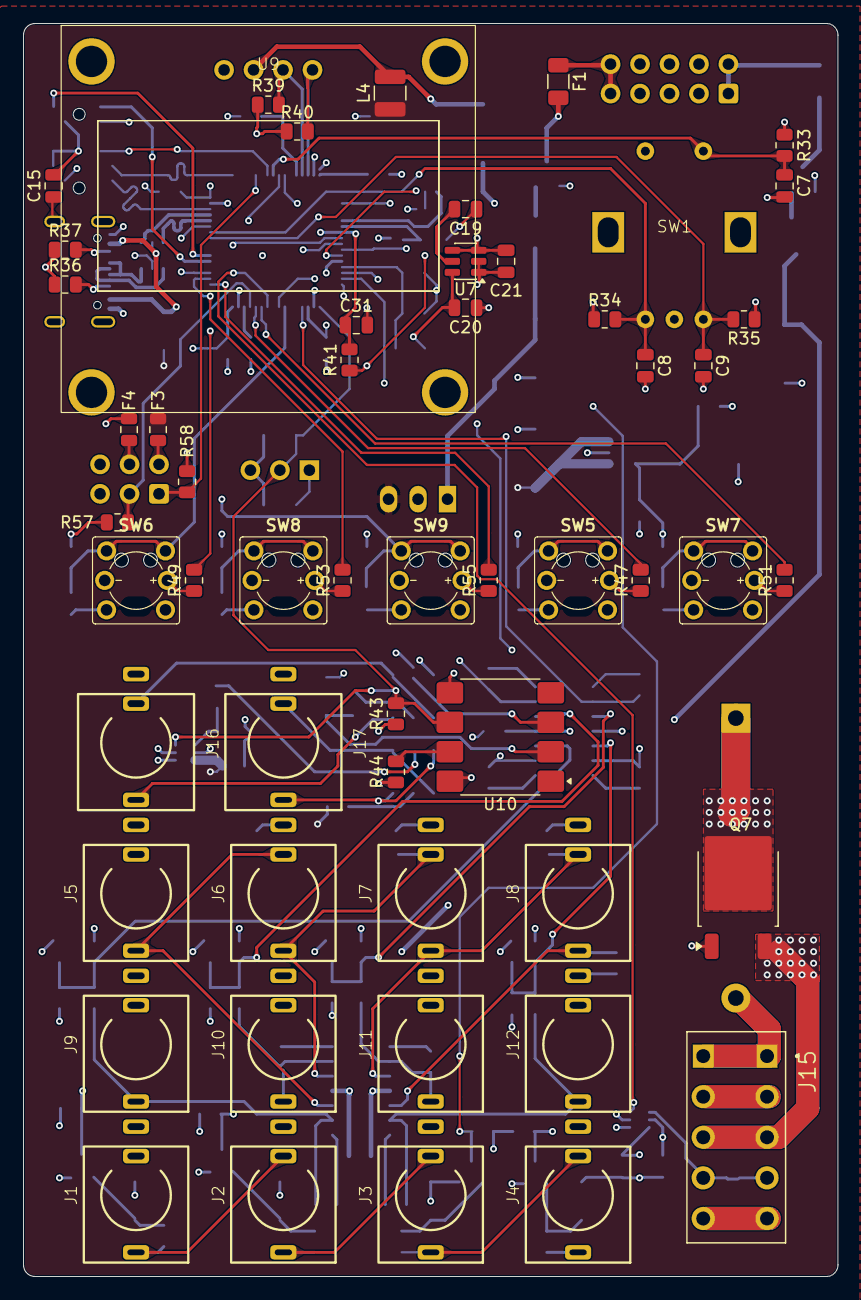
[picture p8: board Light_Commander.kicad_pcb from above]

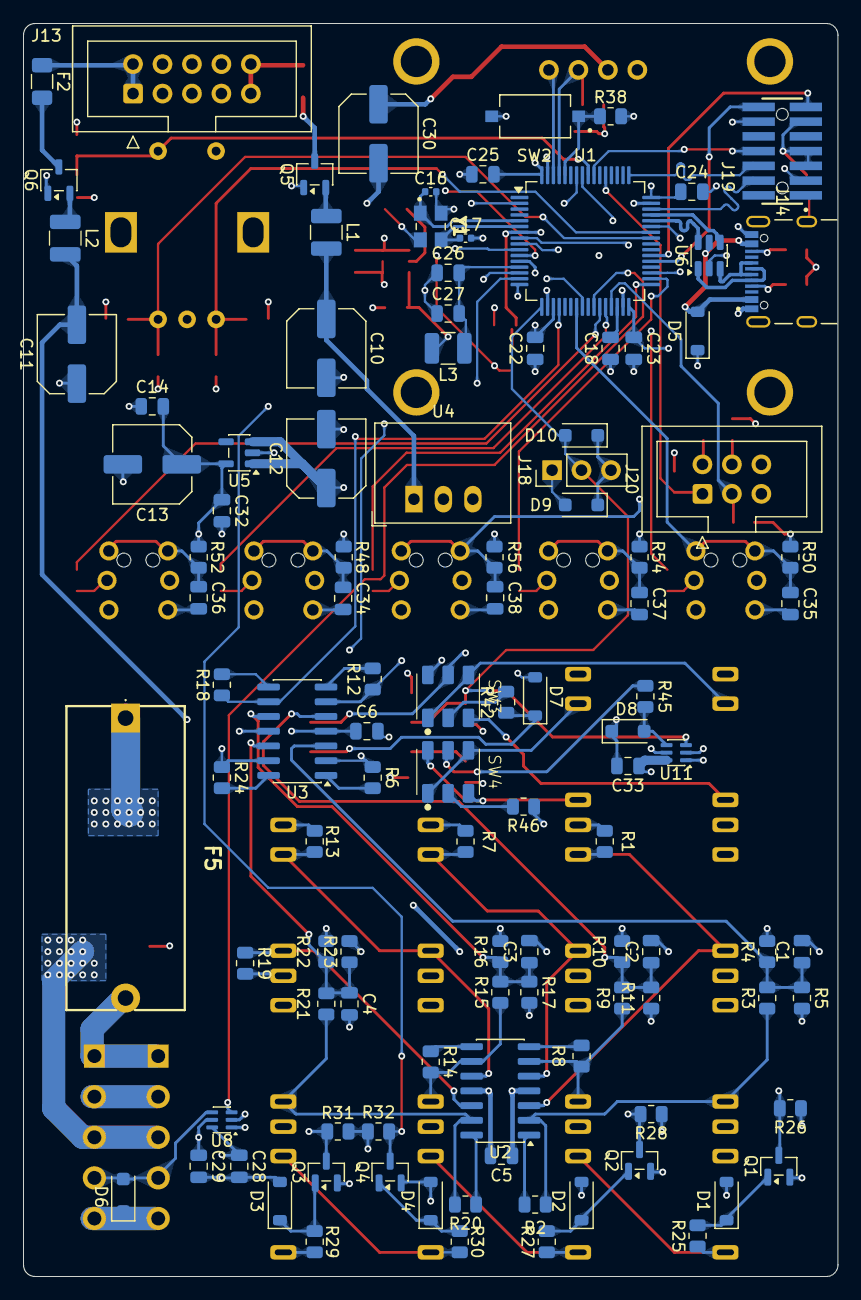
[picture p9: board Light_Commander.kicad_pcb from below]

Board: 6 copper layers, 70.2 x 108.0 mm, 164 parts (109 on the bottom side), 111 nets.
