ethandrzb/Eurorack_WS2812_LED_Controller/Core/Src/main.c

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
/* Includes ------------------------------------------------------------------*/
#include "main.h"

/* USER CODE BEGIN Includes */
#include "../../Drivers/ssd1306/ssd1306.h"
#include <stdbool.h>
#include <stdio.h>
#include "WS2812.h"
//#include "WS2812FX.hpp"
#include "mainWhile.hpp"
/* USER CODE END Includes */

ADC_HandleTypeDef hadc1;
DMA_HandleTypeDef hdma_adc1;

I2C_HandleTypeDef hi2c1;
I2C_HandleTypeDef hi2c2;

SPI_HandleTypeDef hspi3;
DMA_HandleTypeDef hdma_spi3_tx;

TIM_HandleTypeDef htim1;
TIM_HandleTypeDef htim3;
TIM_HandleTypeDef htim6;
TIM_HandleTypeDef htim7;

UART_HandleTypeDef huart2;
UART_HandleTypeDef huart6;

PCD_HandleTypeDef hpcd_USB_OTG_FS;

/* USER CODE BEGIN PV */
char OLED_buffer[30];
uint16_t enc_count = 0;
uint16_t enc_count_prev = 0;

uint8_t effectIndex = 0;
uint8_t menuItemIndex = 0;
uint8_t selectedModSourceIndex = 0;
uint8_t HSVPickerIndex = 0;

menuLayer menu_layer = SIMPLE_PARAMETER_ROOT;
uint8_t encoderLastDirectionForward = 0;

#define UART_TRANSMIT_BUFFER_LENGTH 25
uint8_t UARTTransmitBuffer[UART_TRANSMIT_BUFFER_LENGTH];

#ifdef ENABLE_PERFORMANCE_MONITOR
volatile uint16_t WS2812FramesSent;
#endif

float cpuUsage = 0.0f;
volatile bool overrunDetected = false;

uint16_t rawADCData[NUM_CV_INPUTS];

// Software solution to multiple triggering problem on gate EXTI inputs
// Better PCB design would help this too
// This parameter might be nice to have in the settings menu
#define GATE_LIMIT_FRAMES 10
uint16_t frames_since_last_trigger[NUM_GATE_INPUTS] = {0, 0, 0, 0};
/* USER CODE END PV */

void SystemClock_Config(void);
static void MX_GPIO_Init(void);
static void MX_DMA_Init(void);
static void MX_USART2_UART_Init(void);
static void MX_I2C1_Init(void);
static void MX_TIM6_Init(void);
static void MX_SPI3_Init(void);
static void MX_TIM3_Init(void);
static void MX_TIM1_Init(void);
static void MX_ADC1_Init(void);
static void MX_TIM7_Init(void);
static void MX_USB_OTG_FS_PCD_Init(void);
static void MX_I2C2_Init(void);
static void MX_USART6_UART_Init(void);
/* USER CODE BEGIN 0 */
//TODO: Add a ping-pong buffer for ADC values so we don't have to keep starting conversion and DMA
//void HAL_ADC_ConvCpltCallback(ADC_HandleTypeDef *hadc)
//{
//	// >> 3 to scale to comfortable range
//	WS2812_SetBackgroundColor(rawADCData[0] >> 3, rawADCData[1] >> 3, rawADCData[2] >> 3);
//}


// Detect encoder button presses
// Had to use a timer for this because this button was really noisy
void HAL_TIM_OC_DelayElapsedCallback(TIM_HandleTypeDef *htim)
{
	if(htim == &htim3 && htim->Channel == HAL_TIM_ACTIVE_CHANNEL_1)
	{
		// Menu layer transitions for simple and color menus
		switch(menu_layer)
		{
			case SIMPLE_PARAMETER_ROOT:
				menu_layer = SIMPLE_PARAMETER_VALUE_SELECTED;
				break;
			case SIMPLE_PARAMETER_VALUE_SELECTED:
				menu_layer = SIMPLE_PARAMETER_ROOT;
				break;
			case COLOR_PALETTE_ROOT:
				menu_layer = HSV_PICKER_ROOT;
				break;
			case HSV_PICKER_ROOT:
				menu_layer = HSV_PICKER_VALUE_SELECTED;
				break;
			case HSV_PICKER_VALUE_SELECTED:
				menu_layer = HSV_PICKER_ROOT;
				break;
			case MOD_MATRIX_ROOT:
				menu_layer = MOD_MATRIX_DESTINATION_SELECTED;
				break;
			case MOD_MATRIX_DESTINATION_SELECTED:
				menu_layer = MOD_MATRIX_AMOUNT_SELECTED;
				break;
			case MOD_MATRIX_AMOUNT_SELECTED:
				menu_layer = MOD_MATRIX_DESTINATION_SELECTED;
				break;
			case SETTINGS_ROOT:
				menu_layer = SETTINGS_VALUE_SELECTED;
				break;
			case SETTINGS_VALUE_SELECTED:
				menu_layer = SETTINGS_ROOT;
				break;
			default:
				break;
		}

		updateMenuC();
	}
}

void HAL_GPIO_EXTI_Callback(uint16_t GPIO_Pin)
{
	switch(GPIO_Pin)
	{
		// Handle gate inputs
		case GATE_IN0_Pin:
			if(frames_since_last_trigger[0] >= GATE_LIMIT_FRAMES)
			{
				gateInput0HighCallbackC();
			}
			frames_since_last_trigger[0] = 0;
			break;
		case GATE_IN1_Pin:
			if(frames_since_last_trigger[1] >= GATE_LIMIT_FRAMES)
			{
				gateInput1HighCallbackC();
			}
			frames_since_last_trigger[1] = 0;
			break;
		case GATE_IN2_Pin:
			if(frames_since_last_trigger[2] >= GATE_LIMIT_FRAMES)
			{
				gateInput2HighCallbackC();
			}
			frames_since_last_trigger[2] = 0;
			break;
		case GATE_IN3_Pin:
			if(frames_since_last_trigger[3] >= GATE_LIMIT_FRAMES)
			{
				gateInput3HighCallbackC();
			}
			frames_since_last_trigger[3] = 0;
			break;

		// Handle front panel buttons
		case FX_CHANGE_BTN_Pin:
			menu_layer = SIMPLE_PARAMETER_ROOT;
			updateMenuC();
			break;
		case SETTINGS_BTN_Pin:
			if(menu_layer != SETTINGS_ROOT)
			{
				menuItemIndex = 0;
				menu_layer = SETTINGS_ROOT;
				updateMenuC();
			}
			break;
		case BACK_BTN_Pin:
			//TODO: Find better solution for this when more state transitions require the cursor to remain in its current position
			if(menu_layer != MOD_MATRIX_DESTINATION_SELECTED)
			{
				// Reset cursor position
				menuItemIndex = 0;
			}

			switch(menu_layer)
			{
				case SIMPLE_PARAMETER_ROOT:
					menu_layer = COLOR_PALETTE_ROOT;
					break;
				case SETTINGS_ROOT:
				case SETTINGS_VALUE_SELECTED:
				case SIMPLE_PARAMETER_VALUE_SELECTED:
				case COLOR_PALETTE_ROOT:
					menu_layer = SIMPLE_PARAMETER_ROOT;
					break;
				case HSV_PICKER_ROOT:
					menu_layer = COLOR_PALETTE_ROOT;
					break;
				case HSV_PICKER_VALUE_SELECTED:
					menu_layer = HSV_PICKER_ROOT;
					break;
				case MOD_MATRIX_ROOT:
					menu_layer = SIMPLE_PARAMETER_ROOT;
					break;
				case MOD_MATRIX_DESTINATION_SELECTED:
					// Assign currently selected destination to this mod slot
					updateSelectedModDestinationC();

					menu_layer = MOD_MATRIX_AMOUNT_SELECTED;
					break;
				case MOD_MATRIX_AMOUNT_SELECTED:
					menu_layer = MOD_MATRIX_DESTINATION_SELECTED;
					break;
				default:
					break;
			}
			updateMenuC();
			break;
		case MOD_BTN_Pin:
			if(menu_layer != MOD_MATRIX_ROOT)
			{
				menu_layer = MOD_MATRIX_ROOT;
				updateMenuC();
			}
			break;
	}
}

void HAL_TIM_IC_CaptureCallback(TIM_HandleTypeDef * htim)
{
	// Handle encoder movement
	if(htim == &htim1)
	{
		enc_count_prev = enc_count;
		enc_count = htim->Instance->CNT >> 2;

		encoderLastDirectionForward = !(htim->Instance->CR1 & TIM_CR1_DIR);

		// Check if encoder moved
		if(enc_count != enc_count_prev)
		{
			// FX change button held
			if(HAL_GPIO_ReadPin(FX_CHANGE_BTN_GPIO_Port, FX_CHANGE_BTN_Pin) == GPIO_PIN_RESET)
			{
				if(encoderLastDirectionForward)
				{
					effectIndex = (effectIndex < WS2812FX_NUM_EFFECTS - 1) ? effectIndex + 1 : WS2812FX_NUM_EFFECTS - 1;
				}
				else
				{
					effectIndex = (effectIndex > 0) ? effectIndex - 1 : 0;
				}
			}
			else
			{
				// Trigger change based on current menu_layer
				switch(menu_layer)
				{
					case SIMPLE_PARAMETER_ROOT:
					case COLOR_PALETTE_ROOT:
					case HSV_PICKER_ROOT:
					case MOD_MATRIX_ROOT:
					case MOD_MATRIX_DESTINATION_SELECTED:
					case SETTINGS_ROOT:
						// Use last encoder movement direction to determine whether to increment or decrement the current value
						if(encoderLastDirectionForward)
						{
							incrementMenuItemIndexC();
						}
						else
						{
							decrementMenuItemIndexC();
						}
						break;
					case SIMPLE_PARAMETER_VALUE_SELECTED:
					case MOD_MATRIX_AMOUNT_SELECTED:
					case SETTINGS_VALUE_SELECTED:
						if(encoderLastDirectionForward)
						{
							incrementValueC(effectIndex, menuItemIndex, 0);
						}
						else
						{
							decrementValueC(effectIndex, menuItemIndex, 0);
						}

						break;
					case HSV_PICKER_VALUE_SELECTED:
						if(encoderLastDirectionForward)
						{
							incrementValueC(effectIndex, menuItemIndex, HSVPickerIndex);
						}
						else
						{
							decrementValueC(effectIndex, menuItemIndex, HSVPickerIndex);
						}
						break;
				}
			}

			updateMenuC();
		}
	}
}

void HAL_TIM_PeriodElapsedCallback(TIM_HandleTypeDef *htim)
{
	if(htim == &htim7)
	{
		// Skip rendering this frame if the last one took too long
		if(overrunDetected)
		{
			// Consume overrun and test again
			// Consecutive overruns are possible if updateEffectC is really slow
			overrunDetected = (htim->Instance->SR != 0);
			return;
		}

		// Actual render (update) step
		updateEffectC();

		// Update frame counters for gate inputs
		// Used to prevent double triggers
		for(int i = 0; i < NUM_GATE_INPUTS; i++)
		{
			if(frames_since_last_trigger[i] < GATE_LIMIT_FRAMES)
			{
				frames_since_last_trigger[i]++;
			}
		}

		// Detect overruns after updating effect
		overrunDetected = (htim->Instance->SR != 0);

#ifdef ENABLE_PERFORMANCE_MONITOR
		cpuUsage = (((float)htim->Instance->CNT) / htim->Instance->ARR) * 100.0f;
#endif
	}
#ifdef ENABLE_PERFORMANCE_MONITOR
	// FPS timer
	else if(htim == &htim6)
	{
		// String operations are too slow to have in an ISR, even if preempted by a higher priority interrupt
		sprintf((char *)UARTTransmitBuffer, "%d\n", WS2812FramesSent);

//		HAL_UART_Transmit_IT(&huart2, UARTTransmitBuffer, UART_TRANSMIT_BUFFER_LENGTH);

		// Draw current FPS
		ssd1306_SetCursor(100, 0);
		ssd1306_WriteString((char *)UARTTransmitBuffer, Font_6x8, White);

		if(!overrunDetected)
		{
			// Draw current CPU usage
			sprintf((char *)UARTTransmitBuffer, "%-4.0f", cpuUsage);
		}
		else
		{
			sprintf((char *)UARTTransmitBuffer, "OVER");
		}

		ssd1306_SetCursor(100, 9);
		ssd1306_WriteString((char *)UARTTransmitBuffer, Font_6x8, White);

		ssd1306_UpdateScreen();

		// Reset frame counter
		WS2812FramesSent = 0;
	}
#endif
}

/* USER CODE END 0 */

/**
  * @brief  The application entry point.
  * @retval int
  */
int main(void)
{

  /* MCU Configuration--------------------------------------------------------*/

  /* Reset of all peripherals, Initializes the Flash interface and the Systick. */
  HAL_Init();

  /* Configure the system clock */
  SystemClock_Config();

  /* Initialize all configured peripherals */
  MX_GPIO_Init();
  MX_DMA_Init();
  MX_USART2_UART_Init();
  MX_I2C1_Init();
  MX_TIM6_Init();
  MX_SPI3_Init();
  MX_TIM3_Init();
  MX_TIM1_Init();
  MX_ADC1_Init();
  MX_TIM7_Init();
  MX_USB_OTG_FS_PCD_Init();
  MX_I2C2_Init();
  MX_USART6_UART_Init();
  /* USER CODE BEGIN 2 */

  // Initialize OLED
  ssd1306_Init();
  ssd1306_UpdateScreen();

  ssd1306_SetCursor(0, 0);
  ssd1306_WriteString("LED control", Font_11x18, White);

  ssd1306_UpdateScreen();

  // Start encoder timer
  HAL_TIM_Encoder_Start_IT(&htim1, TIM_CHANNEL_ALL);

  // Start debounce timer for encoder button
  HAL_TIM_OnePulse_Start_IT(&htim3, TIM_CHANNEL_1);

  // Initialize all LEDs to off
  WS2812_ClearLEDs();
  WS2812_SetBackgroundColor(0, 0, 0);
  WS2812_SendAll();

#ifdef ENABLE_PERFORMANCE_MONITOR
  HAL_TIM_Base_Start_IT(&htim6);
#endif

  // Frame timer is started in mainWhiteCpp
  /* USER CODE END 2 */

  /* Infinite loop */
  /* USER CODE BEGIN WHILE */
  while (1)
  {
	  mainWhileC();
    /* USER CODE END WHILE */

    /* USER CODE BEGIN 3 */
  }
  /* USER CODE END 3 */
}

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
