ethandrzb/Eurorack_WS2812_LED_Controller/Core/Inc/main.h

#define MIDI_BTN_Pin GPIO_PIN_13
#define MIDI_BTN_GPIO_Port GPIOC
#define MIDI_BTN_EXTI_IRQn EXTI15_10_IRQn
#define GATE_IN1_Pin GPIO_PIN_0
#define GATE_IN1_GPIO_Port GPIOC
#define GATE_IN1_EXTI_IRQn EXTI0_IRQn
#define GATE_IN0_Pin GPIO_PIN_1
#define GATE_IN0_GPIO_Port GPIOC
#define GATE_IN0_EXTI_IRQn EXTI1_IRQn
#define GATE_IN3_Pin GPIO_PIN_2
#define GATE_IN3_GPIO_Port GPIOC
#define GATE_IN3_EXTI_IRQn EXTI2_IRQn
#define GATE_IN2_Pin GPIO_PIN_3
#define GATE_IN2_GPIO_Port GPIOC
#define GATE_IN2_EXTI_IRQn EXTI3_IRQn
#define CV_IN0_Pin GPIO_PIN_0
#define CV_IN0_GPIO_Port GPIOA
#define CV_IN1_Pin GPIO_PIN_1
#define CV_IN1_GPIO_Port GPIOA
#define USART_TX_Pin GPIO_PIN_2
#define USART_TX_GPIO_Port GPIOA
#define USART_RX_Pin GPIO_PIN_3
#define USART_RX_GPIO_Port GPIOA
#define CV_IN2_Pin GPIO_PIN_4
#define CV_IN2_GPIO_Port GPIOA
#define LED1_Pin GPIO_PIN_5
#define LED1_GPIO_Port GPIOA
#define LED2_Pin GPIO_PIN_6
#define LED2_GPIO_Port GPIOA
#define BACK_BTN_Pin GPIO_PIN_7
#define BACK_BTN_GPIO_Port GPIOA
#define BACK_BTN_EXTI_IRQn EXTI9_5_IRQn
#define CV_IN3_Pin GPIO_PIN_4
#define CV_IN3_GPIO_Port GPIOC
#define MIDI_LED_Pin GPIO_PIN_1
#define MIDI_LED_GPIO_Port GPIOB
#define SETTINGS_LED_Pin GPIO_PIN_2
#define SETTINGS_LED_GPIO_Port GPIOB
#define FX_CHANGE_LED_Pin GPIO_PIN_12
#define FX_CHANGE_LED_GPIO_Port GPIOB
#define MOD_LED_Pin GPIO_PIN_13
#define MOD_LED_GPIO_Port GPIOB
#define BACK_LED_Pin GPIO_PIN_14
#define BACK_LED_GPIO_Port GPIOB
#define FX_CHANGE_BTN_Pin GPIO_PIN_10
#define FX_CHANGE_BTN_GPIO_Port GPIOA
#define FX_CHANGE_BTN_EXTI_IRQn EXTI15_10_IRQn
#define TMS_Pin GPIO_PIN_13
#define TMS_GPIO_Port GPIOA
#define TCK_Pin GPIO_PIN_14
#define TCK_GPIO_Port GPIOA
#define SWO_Pin GPIO_PIN_3
#define SWO_GPIO_Port GPIOB
#define ENC_BTN_Pin GPIO_PIN_4
#define ENC_BTN_GPIO_Port GPIOB
#define MOD_BTN_Pin GPIO_PIN_5
#define MOD_BTN_GPIO_Port GPIOB
#define MOD_BTN_EXTI_IRQn EXTI9_5_IRQn
#define SETTINGS_BTN_Pin GPIO_PIN_6
#define SETTINGS_BTN_GPIO_Port GPIOB
#define SETTINGS_BTN_EXTI_IRQn EXTI9_5_IRQn
#define NUM_CV_INPUTS 4
#define NUM_GATE_INPUTS 4
