ethandrzb/Eurorack_WS2812_LED_Controller/Core/Src/ByteToWS2812DataLookupTable.c

/*
 * ByteToWS2812DataLookupTable.c
 *
 *  Created on: Feb 14, 2025
 *      Author: ethan
 */

#include "ByteToWS2812DataLookupTable.h"

const uint8_t byteToWS2812DataLUT[256][8] = {
{0b100, 0b100, 0b100, 0b100, 0b100, 0b100, 0b100, 0b100},
{0b100, 0b100, 0b100, 0b100, 0b100, 0b100, 0b100, 0b110},
{0b100, 0b100, 0b100, 0b100, 0b100, 0b100, 0b110, 0b100},
{0b100, 0b100, 0b100, 0b100, 0b100, 0b100, 0b110, 0b110},
{0b100, 0b100, 0b100, 0b100, 0b100, 0b110, 0b100, 0b100},
{0b100, 0b100, 0b100, 0b100, 0b100, 0b110, 0b100, 0b110},
{0b100, 0b100, 0b100, 0b100, 0b100, 0b110, 0b110, 0b100},
{0b100, 0b100, 0b100, 0b100, 0b100, 0b110, 0b110, 0b110},
{0b100, 0b100, 0b100, 0b100, 0b110, 0b100, 0b100, 0b100},
{0b100, 0b100, 0b100, 0b100, 0b110, 0b100, 0b100, 0b110},
{0b100, 0b100, 0b100, 0b100, 0b110, 0b100, 0b110, 0b100},
{0b100, 0b100, 0b100, 0b100, 0b110, 0b100, 0b110, 0b110},
{0b100, 0b100, 0b100, 0b100, 0b110, 0b110, 0b100, 0b100},
{0b100, 0b100, 0b100, 0b100, 0b110, 0b110, 0b100, 0b110},
{0b100, 0b100, 0b100, 0b100, 0b110, 0b110, 0b110, 0b100},
{0b100, 0b100, 0b100, 0b100, 0b110, 0b110, 0b110, 0b110},
{0b100, 0b100, 0b100, 0b110, 0b100, 0b100, 0b100, 0b100},
{0b100, 0b100, 0b100, 0b110, 0b100, 0b100, 0b100, 0b110},
{0b100, 0b100, 0b100, 0b110, 0b100, 0b100, 0b110, 0b100},
{0b100, 0b100, 0b100, 0b110, 0b100, 0b100, 0b110, 0b110},
{0b100, 0b100, 0b100, 0b110, 0b100, 0b110, 0b100, 0b100},
{0b100, 0b100, 0b100, 0b110, 0b100, 0b110, 0b100, 0b110},
{0b100, 0b100, 0b100, 0b110, 0b100, 0b110, 0b110, 0b100},
{0b100, 0b100, 0b100, 0b110, 0b100, 0b110, 0b110, 0b110},
{0b100, 0b100, 0b100, 0b110, 0b110, 0b100, 0b100, 0b100},
{0b100, 0b100, 0b100, 0b110, 0b110, 0b100, 0b100, 0b110},
{0b100, 0b100, 0b100, 0b110, 0b110, 0b100, 0b110, 0b100},
{0b100, 0b100, 0b100, 0b110, 0b110, 0b100, 0b110, 0b110},
{0b100, 0b100, 0b100, 0b110, 0b110, 0b110, 0b100, 0b100},
{0b100, 0b100, 0b100, 0b110, 0b110, 0b110, 0b100, 0b110},
{0b100, 0b100, 0b100, 0b110, 0b110, 0b110, 0b110, 0b100},
{0b100, 0b100, 0b100, 0b110, 0b110, 0b110, 0b110, 0b110},
{0b100, 0b100, 0b110, 0b100, 0b100, 0b100, 0b100, 0b100},
{0b100, 0b100, 0b110, 0b100, 0b100, 0b100, 0b100, 0b110},
{0b100, 0b100, 0b110, 0b100, 0b100, 0b100, 0b110, 0b100},
{0b100, 0b100, 0b110, 0b100, 0b100, 0b100, 0b110, 0b110},
{0b100, 0b100, 0b110, 0b100, 0b100, 0b110, 0b100, 0b100},
{0b100, 0b100, 0b110, 0b100, 0b100, 0b110, 0b100, 0b110},
{0b100, 0b100, 0b110, 0b100, 0b100, 0b110, 0b110, 0b100},
{0b100, 0b100, 0b110, 0b100, 0b100, 0b110, 0b110, 0b110},
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
};
