ethandrzb/Eurorack_WS2812_LED_Controller/Core/Inc/ByteToWS2812DataLookupTable.h

/*
 * ByteToWS2812DataLookupTable.h
 *
 *  Created on: Feb 14, 2025
 *      Author: ethan
 */

#ifndef INC_BYTETOWS2812DATALOOKUPTABLE_H_
#define INC_BYTETOWS2812DATALOOKUPTABLE_H_

#include <stdint.h>

extern const uint8_t byteToWS2812DataLUT[256][8];

#endif /* INC_BYTETOWS2812DATALOOKUPTABLE_H_ */
