ethandrzb/Eurorack_WS2812_LED_Controller/(commit log)

2025-01-05 Add basic LED effect
2025-01-06 Move logic for updating menu on screen to interrupts triggered by encoder and encoder press
2025-01-11 Fix encoder button bouncing
    [Eurorack_WS2812_LED_Controller.ioc, main.c, main.h]
2025-01-15 Working through compiler and linker errors
    [WS2812FX.hpp, mainWhile.cpp]
2025-01-21 Fix C++ compilation and linker errors
    [WS2812FX.hpp, mainWhile.cpp]
2025-01-21 Fix issues with pointer casting
    [WS2812FX.hpp, mainWhile.cpp]
2025-01-28 Fix WS2812Effect wrapper and parameter classes and retrieve values in SimpleBreathingEffect
    [WS2812FX.hpp]
2025-01-28 Fix bug preventing delay from working
    [WS2812FX.hpp]
2025-01-30 Add increment and decrement functions for NumericEffectParameters, connect to encoder, and adjust OLED text positions
2025-02-01 Add back button on PC7 to streamline UX
2025-02-01 Fix ISO C++ warning about using constant string as char pointer and clarify comments
    [WS2812FX.hpp, main.c, mainWhile.cpp]
2025-02-01 Start of effect switching
2025-02-08 Limit menuItemIndex based on currently displayed menu and fix wraparound behavior for certain index limits
    [main.c, mainWhile.cpp, mainWhile.hpp]
2025-02-09 Menu cursor no longer wraps around
    [mainWhile.cpp]
2025-02-09 Cursor in HSVPicker no longer wraps around
    [main.c]
2025-02-09 Fix transition from HSVPicker to color palette
    [main.c]
2025-02-09 Change flip and mirror parameters of MeterEffect to BooleanEffectParameters
    [WS2812FX.hpp, mainWhile.cpp]
2025-02-11 Move encoder from TIM2 to TIM1 to free pins for ADC1
2025-02-11 Disable unused interrupts from TIM1
2025-02-11 Changing the active effect resets the menu state and cursor position
    [main.c]
2025-02-14 Remove 2nd LSB from ADC inputs
2025-02-15 Fix byte ordering in LUT-optimized send function
    [WS2812.c]
2025-02-18 Convert menu switcher to switch statement
2025-02-18 Change optimization level to O1 and add barrier instructions to ensure correct output
    [WS2812.c]
2025-06-20 Add sequence diagram for mod matrix operation and change mod source to pointer to ADC value
2025-07-07 Use parameter bounds as linear mapping function for modulation and move to larger signed values to fix casting issues
    [WS2812.c, WS2812.h, WS2812FX.hpp, mainWhile.cpp]
2025-08-10 Indicate currently active mod destination for selected mod source
2025-08-10 Can assign currently selected destination to current mod source using back button
2025-08-14 Assign correct pointer type to noneEffectParameter
    [WS2812FX.hpp]
2025-08-14 Rename numeric parameter menu to simple parameter menu and fix bug preventing background from appearing in color palette
    [WS2812FX.hpp, main.c, main.h, mainWhile.cpp, mainWhile.hpp]
2025-08-16 Change meter level to 16 bit value to accommodate longer LED strips
2025-08-16 Add external interrupt for triggering events
2025-08-28 Move back button pin
2025-11-04 Start of migration from HAL_Delay to timer interrupts for frame timing
2025-11-04 Add missing notes to docs
    [LED controller tesselation.xlsx]
2025-11-04 Use LED_SPI macro for SPI peripheral reference in WS2812_SendAll
2025-11-25 Defer GUI render to shorten time spent in ISRs and make effects more responsive to manual changes
    [mainWhile.cpp]
2025-11-25 Invert behavior of fractalization to make it more intuitive
    [WS2812.c, WS2812.h, mainWhile.cpp]
2025-11-25 Detect frame timer overruns to skip current effect update if the last one took too long for the current frame timing
    [WS2812.c, WS2812.h, main.c]
2025-11-26 Fix interaction between fractal and downsampling
    [WS2812.c]
2025-12-09 Use faster ADC sampling time for CV inputs
2025-12-09 Check for and fix extreme hue values in WS2812_HSVToRGB
    [WS2812.c]
2025-12-30 Add method to replace pointer managed by an EffectParameter with a pointer to an existing variable
    [WS2812FX.hpp, mainWhile.cpp]
2025-12-30 Add function to set one or more LEDs based on a non-integer index
2025-12-30 Add alias function for setting an LED with a floating point index
2025-12-30 Change non-mirrored meters to percentage mode and fix issue with last commit
    [WS2812.c, WS2812.h]
2025-12-31 Rework continuous draw function
    [WS2812.c, WS2812.h]
2025-12-31 Increase ADC resolution on CV inputs to 10 bits
2026-01-12 Use padded value of LED strip length for both effect render length and send length
2026-01-12 Add offset setting for physical starting index on LED strip
2026-01-13 Fix initial mod matrix settings for ScopeEffect to properly map CV inputs to value of each trace's color
2026-01-13 Start of noise gate on modulation inputs
    [WS2812FX.hpp]
2026-01-14 Add macro to enable or disable noise gate on CV inputs
    [WS2812FX.hpp]
2026-03-08 Add frame-based delay to help with double triggers from gate inputs
2026-05-30 Start of PCB
    [Light_Commander.kicad_pcb, Light_Commander.kicad_sch, analog.kicad_sch, digital.kicad_sch]
2026-06-13 Power and UI on PCB
    [Light_Commander.kicad_sch, UI.kicad_sch, analog.kicad_sch, digital.kicad_sch, power.kicad_sch]
2026-06-17 Fix hardcoded test strip length
    [mainWhile.cpp]
2026-06-30 Voltage ref, BOOT0, and connections on PCB
    [Light_Commander.kicad_sch, digital.kicad_sch, power.kicad_sch]
2026-07-03 Add OLED, LED strip connector, and LED level shifter to schematic
    [Light_Commander.kicad_sch, digital.kicad_sch]
2026-07-05 Add MDI in and thru to schematic
    [Light_Commander.kicad_sch, UI.kicad_sch, digital.kicad_sch]
2026-07-05 Add buttons, SWD, and LED reverse polarity protection to schematic
    [Light_Commander.kicad_sch, UI.kicad_sch, analog.kicad_sch, digital.kicad_sch, power.kicad_sch]
2026-07-05 Fix footprints and finish first draft of schematic
    [Light_Commander.kicad_pcb, Light_Commander.kicad_sch, analog.kicad_sch, digital.kicad_sch]
2026-07-11 Start of PCB design
    [Light_Commander.kicad_pcb, Light_Commander.kicad_sch, Light_Commander_panel.kicad_pcb, Light_Commander_panel.step, power.kicad_sch]
2026-07-11 Reduce solder mask margin of USB C port footprint to prevent bridges
    [Light_Commander.kicad_pcb]
2026-07-17 Initial component placement
    [Light_Commander.kicad_pcb, Light_Commander_panel.kicad_pcb, Light_Commander_panel.step, digital.kicad_sch]
2026-08-01 Start of trace routing
    [Light_Commander.kicad_pcb, UI.kicad_sch]
2026-08-01 Add remaining IO from schematic to CubeMX project
    [digital.kicad_sch]
2026-08-01 More routing
    [Light_Commander.kicad_pcb]
2026-08-31 Switch to 6 layer board, use JLC06161H-7628 stackup, and continue routing
    [Light_Commander.kicad_pcb]
2026-08-31 Add PCB layout notes
2026-09-26 Route gate inputs
    [Light_Commander.kicad_pcb]
2026-09-26 Route high current power for LED strip
    [Light_Commander.kicad_pcb]
2026-09-26 Impedance controlled routing for USB signals
    [Light_Commander.kicad_pcb]
2026-09-30 Initial PCB review from Mylo
    [Light_Commander.kicad_pcb, Light_Commander_panel.kicad_pcb, Light_Commander_panel.step, digital.kicad_sch]
