ethandrzb/Eurorack_WS2812_LED_Controller/(notices)

Notices in the files:
Core/Inc/main.h:
Copyright (c) 2025 STMicroelectronics.
All rights reserved.
This software is licensed under terms that can be found in the LICENSE file
Core/Src/main.c:
Copyright (c) 2024 STMicroelectronics.
